GiacomoZampieri/Progetto-IoT/catture/ScreenCircuito.png

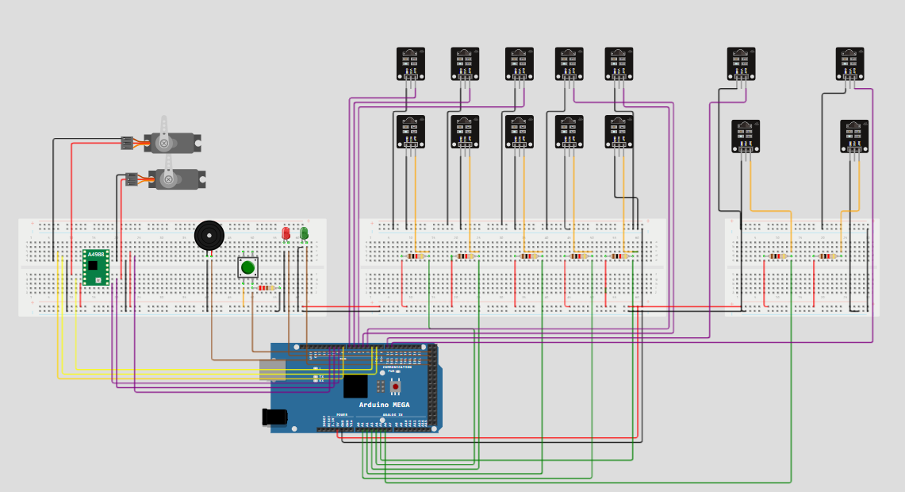
catture/ScreenCircuito.png
