GiacomoZampieri/Progetto-IoT/(commit log)

2024-05-30 Diagramma di flusso del funzionamento
    .ddd estensione per Diagram Designer (per diagramma effettivo vedere relazione o catture)
2024-06-06 Rename cccc.ddd to diagramma.ddd
    Modifcato il titolo del file diagramma
2024-06-06 visto e modificato
    Non ho voglia di fare un branch, quindi pusho in main
